DiyaJabin/autonomous-conveyor-sorting-cell/ros2_ws/src/sorting_cell/sorting_cell/arm_controller.py

"""ROS 2 Arm Controller Node for Autonomous Conveyor Sorting Cell.

Subscribes to /arm/command, validates and parses commands against configurable
joint limits, transmits commands to the low-level Arduino controller via serial,
and publishes execution status on /arm/status.
"""

from dataclasses import dataclass
from typing import Callable, Dict, List, Optional, Tuple
import sys

# Conditional import to allow pure Python parsing & unit testing on systems without rclpy
try:
    import rclpy
    from rclpy.node import Node
    from std_msgs.msg import String
    RCLPY_AVAILABLE = True
except ImportError:
    rclpy = None
    Node = object
    String = None
    RCLPY_AVAILABLE = False

from sorting_cell.serial_interface import SerialInterface


@dataclass
class JointRange:
    """Configurable angular limits for a single arm joint."""
    min_angle: float
    max_angle: float

    def contains(self, angle: float) -> bool:
        return self.min_angle <= angle <= self.max_angle


class ArmCommandParser:
    """Parses and validates incoming ROS commands against centralized joint limits.

    Converts valid ROS commands into the corresponding serial protocol string.
    Never crashes on malformed or out-of-range input.
    """

    SUPPORTED_JOINTS = ("BASE", "SHOULDER", "ELBOW", "WRIST", "WRIST_PITCH")
    VALID_GRIPPER_STATES = ("OPEN", "CLOSE")

    def __init__(self, joint_limits: Optional[Dict[str, JointRange]] = None) -> None:
        """Initialize the parser with configurable joint limits.

        These defaults mirror the arm_controller node's joint_limits.*
        parameters and are wide enough to admit every pose in
        config/arm_positions.yaml. They are a software guard against typos,
        not measured mechanical limits of the arm. The firmware itself only
        rejects angles outside 0-180.
        """
        self.joint_limits: Dict[str, JointRange] = joint_limits or {
            "BASE": JointRange(min_angle=0.0, max_angle=180.0),
            "SHOULDER": JointRange(min_angle=15.0, max_angle=165.0),
            # ELBOW max widened to 175.0 to admit the measured positions in
            # config/arm_positions.yaml (PICK_DOWN/RFID_SCAN elbow=175).
            "ELBOW": JointRange(min_angle=15.0, max_angle=175.0),
            "WRIST": JointRange(min_angle=0.0, max_angle=180.0),
            "WRIST_PITCH": JointRange(min_angle=0.0, max_angle=180.0),
        }

    def update_joint_limit(self, joint_name: str, min_angle: float, max_angle: float) -> None:
        """Update limit for a specific joint."""
        joint_name = joint_name.upper()
        self.joint_limits[joint_name] = JointRange(min_angle=min_angle, max_angle=max_angle)

    def parse(self, raw_command: str) -> Tuple[bool, Optional[str], Optional[str], Optional[str]]:
        """Parse and validate a raw command string.

        :param raw_command: Command received from /arm/command (e.g. 'BASE 90', 'HOME', 'GRIPPER OPEN')
        :return: Tuple of:
                 - is_valid (bool)
                 - serial_command (str or None)
                 - action_name (str or None, e.g. 'BASE', 'HOME', 'GRIPPER')
                 - error_detail (str or None)
        """
        if not raw_command or not isinstance(raw_command, str):
            return False, None, None, "EMPTY_COMMAND"

        tokens = raw_command.strip().split()
        if not tokens:
            return False, None, None, "EMPTY_COMMAND"

        verb = tokens[0].upper()

        # 1. HOME command
        if verb == "HOME":
            if len(tokens) != 1:
                return False, None, None, "UNEXPECTED_ARGUMENTS_FOR_HOME"
            return True, "HOME", "HOME", None

        # 2. GRIPPER command: GRIPPER OPEN | GRIPPER CLOSE
        if verb == "GRIPPER":
            if len(tokens) != 2:
                return False, None, None, "INVALID_GRIPPER_FORMAT"
            state = tokens[1].upper()
            if state not in self.VALID_GRIPPER_STATES:
                return False, None, None, f"INVALID_GRIPPER_STATE:{tokens[1]}"
            return True, f"GRIPPER:{state}", "GRIPPER", None

        # 3. Joint angle commands: BASE <angle>, SHOULDER <angle>, ELBOW <angle>,
        #    WRIST <angle>, WRIST_PITCH <angle>
        if verb in self.SUPPORTED_JOINTS:
            if len(tokens) != 2:
                return False, None, None, f"MISSING_OR_EXTRA_ANGLE_ARGUMENT_FOR_{verb}"

            raw_angle = tokens[1]
            try:
                angle = float(raw_angle)
            except ValueError:
                return False, None, None, f"NON_NUMERIC_ANGLE:{raw_angle}"

            # Validate against configured limits
            limits = self.joint_limits.get(verb)
            if limits and not limits.contains(angle):
                return False, None, None, (
                    f"ANGLE_OUT_OF_LIMITS:{angle} (allowed: [{limits.min_angle}, {limits.max_angle}])"
                )

            # Format as integer angle in serial protocol (e.g. BASE:90)
            angle_int = int(round(angle))
            return True, f"{verb}:{angle_int}", verb, None

        # 4. Any other unrecognized verb
        return False, None, None, f"UNKNOWN_COMMAND:{verb}"


class ArmControllerCore:
    """Core orchestration and status management for the robotic arm subsystem.

    Decoupled from ROS 2 middleware to allow 100% unit and integration testing
    on any platform without requiring an active DDS/rclpy runtime.
    """

    def __init__(
        self,
        parser: ArmCommandParser,
        serial_interface: SerialInterface,
        status_publisher: Optional[Callable[[str], None]] = None,
        logger: Optional[Callable[[str], None]] = None,
    ) -> None:
        self.parser = parser
        self.serial_interface = serial_interface
        self._status_publisher = status_publisher or (lambda status: None)
        self._logger = logger or (lambda msg: None)
        self.last_status: Optional[str] = None
        self.status_history: List[str] = []

    def publish_status(self, status_text: str) -> None:
        """Record and broadcast status update."""
        self.last_status = status_text
        self.status_history.append(status_text)
        self._status_publisher(status_text)

    def log(self, msg: str) -> None:
        """Helper to output log message."""
        self._logger(msg)

    def process_command(self, raw_cmd: str) -> str:
        """Process an incoming command string through validation, serial transmission, and status emission.

        Flow:
          1. Parse & validate raw command against limits.
          2. If invalid: emit 'ERROR:INVALID_COMMAND' and return.
          3. If valid: emit 'EXECUTING:<ACTION>' status.
          4. Transmit newline-terminated command via serial interface.
          5. On serial error: emit returned error status ('ERROR:SERIAL_TIMEOUT', 'ERROR:ARDUINO_DISCONNECTED', etc.).
          6. On serial success: emit returned OK status ('OK:BASE', 'OK:HOME', 'OK:GRIPPER', etc.).

        :param raw_cmd: Raw command string (e.g. 'BASE 90', 'HOME', 'GRIPPER OPEN')
        :return: Final status string published to /arm/status
        """
        clean_cmd = raw_cmd.strip() if isinstance(raw_cmd, str) else ""
        self.log(f"Received command: {clean_cmd}")

        is_valid, serial_cmd, action_name, error_detail = self.parser.parse(clean_cmd)

        if not is_valid:
            self.log(f"Command validation failed ({error_detail}): '{clean_cmd}'")
            self.publish_status("ERROR:INVALID_COMMAND")
            return "ERROR:INVALID_COMMAND"

        # Broadcast executing state
        self.publish_status(f"EXECUTING:{action_name}")

        # Send command over serial (real or mock)
        success, response = self.serial_interface.send_and_receive(serial_cmd)

        if not success:
            self.log(f"Serial communication failed: {response}")
            self.publish_status(response)
            return response

        # Command succeeded
        self.publish_status(response)
        return response


class ArmControllerNode(Node):
    """ROS 2 Node controlling the robotic arm subsystem."""

    def __init__(self) -> None:
        if not RCLPY_AVAILABLE:
            raise RuntimeError("rclpy is not available in this environment")

        super().__init__('arm_controller')

        # Declare configurable parameters
        self.declare_parameter('mock_mode', False)
        self.declare_parameter('serial_port', '/dev/ttyACM0')
        self.declare_parameter('baud_rate', 115200)
        self.declare_parameter('serial_timeout', 1.0)

        # Configurable joint limits (degrees). Every /arm/command angle is
        # checked against these before it is sent to the Arduino. They are a
        # software guard, not measured mechanical limits.
        self.declare_parameter('joint_limits.base.min', 0.0)
        self.declare_parameter('joint_limits.base.max', 180.0)
        self.declare_parameter('joint_limits.shoulder.min', 15.0)
        self.declare_parameter('joint_limits.shoulder.max', 165.0)
        self.declare_parameter('joint_limits.elbow.min', 15.0)
        # elbow.max must cover the measured positions in config/arm_positions.yaml.
        self.declare_parameter('joint_limits.elbow.max', 175.0)
        self.declare_parameter('joint_limits.wrist.min', 0.0)
        self.declare_parameter('joint_limits.wrist.max', 180.0)
        self.declare_parameter('joint_limits.wrist_pitch.min', 0.0)
        self.declare_parameter('joint_limits.wrist_pitch.max', 180.0)

        # Declared but not read anywhere. The cycle's home pose is
        # HOME_POSITION in config/arm_positions.yaml, and the firmware HOME
        # command uses the firmware's own all-zero angles.
        self.declare_parameter('home_positions.base', 90.0)
        self.declare_parameter('home_positions.shoulder', 90.0)
        self.declare_parameter('home_positions.elbow', 90.0)
        self.declare_parameter('home_positions.wrist', 90.0)
        self.declare_parameter('home_positions.wrist_pitch', 90.0)

        # Retrieve parameters
        self.mock_mode = self.get_parameter('mock_mode').get_parameter_value().bool_value
        self.serial_port = self.get_parameter('serial_port').get_parameter_value().string_value
        self.baud_rate = self.get_parameter('baud_rate').get_parameter_value().integer_value
        self.serial_timeout = self.get_parameter('serial_timeout').get_parameter_value().double_value

        # Initialize joint limits dictionary from parameters
        joint_limits = {
            "BASE": JointRange(
                self.get_parameter('joint_limits.base.min').get_parameter_value().double_value,
                self.get_parameter('joint_limits.base.max').get_parameter_value().double_value,
            ),
            "SHOULDER": JointRange(
                self.get_parameter('joint_limits.shoulder.min').get_parameter_value().double_value,
                self.get_parameter('joint_limits.shoulder.max').get_parameter_value().double_value,
            ),
            "ELBOW": JointRange(
                self.get_parameter('joint_limits.elbow.min').get_parameter_value().double_value,
                self.get_parameter('joint_limits.elbow.max').get_parameter_value().double_value,
            ),
            "WRIST": JointRange(
                self.get_parameter('joint_limits.wrist.min').get_parameter_value().double_value,
                self.get_parameter('joint_limits.wrist.max').get_parameter_value().double_value,
            ),
            "WRIST_PITCH": JointRange(
                self.get_parameter('joint_limits.wrist_pitch.min').get_parameter_value().double_value,
                self.get_parameter('joint_limits.wrist_pitch.max').get_parameter_value().double_value,
            ),
        }

        self.parser = ArmCommandParser(joint_limits=joint_limits)

        # Initialize serial interface
        self.serial_interface = SerialInterface(
            port=self.serial_port,
            baudrate=self.baud_rate,
            timeout=self.serial_timeout,
            mock_mode=self.mock_mode,
            logger=lambda msg: self.get_logger().info(msg),
        )

        # ROS 2 Publisher: /arm/status
        self.status_publisher = self.create_publisher(String, '/arm/status', 10)

        # Initialize core logic
        self.core = ArmControllerCore(
            parser=self.parser,
            serial_interface=self.serial_interface,
            status_publisher=self.publish_status,
            logger=lambda msg: self.get_logger().info(msg),
        )

        # ROS 2 Subscriber: /arm/command
        self.command_subscription = self.create_subscription(
            String,
            '/arm/command',
            self.command_callback,
            10,
        )

        # Connect serial interface (or mock)
        success, status = self.serial_interface.connect()
        if not success:
            self.get_logger().warn(f"Initial serial connection issue: {status}")
            self.core.publish_status("ERROR:SERIAL_CONNECTION")
        else:
            self.core.publish_status("IDLE")

        self.get_logger().info(
            f"arm_controller node started (mock_mode={self.mock_mode}, port={self.serial_port})"
        )

    def publish_status(self, status_text: str) -> None:
        """Publish a status message to /arm/status."""
        msg = String()
        msg.data = status_text
        self.status_publisher.publish(msg)

    def command_callback(self, msg: String) -> None:
        """Process incoming command message from /arm/command."""
        self.core.process_command(msg.data)


def main(args=None) -> None:
    """Main entry point for arm_controller node."""
    if not RCLPY_AVAILABLE:
        print("ERROR: rclpy is required to run the ROS 2 node.", file=sys.stderr)
        sys.exit(1)

    rclpy.init(args=args)
    node = ArmControllerNode()
    try:
        rclpy.spin(node)
    except KeyboardInterrupt:
        pass
    finally:
        node.serial_interface.disconnect()
        node.destroy_node()
        rclpy.shutdown()


if __name__ == '__main__':
    main()
