DiyaJabin/autonomous-conveyor-sorting-cell/(commit log)

2026-09-21 Real hardware integration: firmware calibration, gripper fix, working RFID over I2C, measured arm positions
    [arm_controller.ino, arm_controller.py, object_map.py, positions.py, rfid_reader.py, serial_interface.py]
2026-10-20 WIP: two-bin sorting, new tags, re-measured pick/scan poses, lift step, stronger grip
    - Bins reduced to BIN_A (base 85) and BIN_B (base 110); BIN_C removed
    - object_map: 5 real tags (2 -> BIN_A, 3 -> BIN_B), old tags removed
    - Re-measured PICK_DOWN and RFID_SCAN poses; FLOATING shares the scan base so the move to a bin is a base rotation only
    - New LIFT_POSITION and LIFT_AFTER_GRIP step before the scan
    - Settle waits and joint gap between moves; elbow limit raised to 175
    - Gripper close angle 30 -> 20 for a firmer grip (needs a re-flash of the Arduino)
    Not yet verified on the arm: LIFT_POSITION (derived), BIN_B shoulder and wrist, the new scan height, read rate with the new tags.
2026-10-20 Final cleanup: rewrite README, align docs with code, add wiring guide and LICENSE
    - README rewritten: scope, architecture, setup, running, configuration, verification status, troubleshooting
    - docs/ and hardware/WIRING.md aligned with the code
    - Comment and docstring fixes only, no behaviour changes
    - requirements.txt: added RPi.GPIO; .gitignore: build, install and log ignored at any level
    - Added LICENSE (Apache-2.0, matching package.xml and setup.py)
    - Removed unused .gitkeep placeholders
    [arm_controller.ino, arm_controller.py, object_map.py, positions.py, rfid_reader.py, sorting_controller.py]
